0x0lor1n/spi-clip-rig/docs/schematic.png

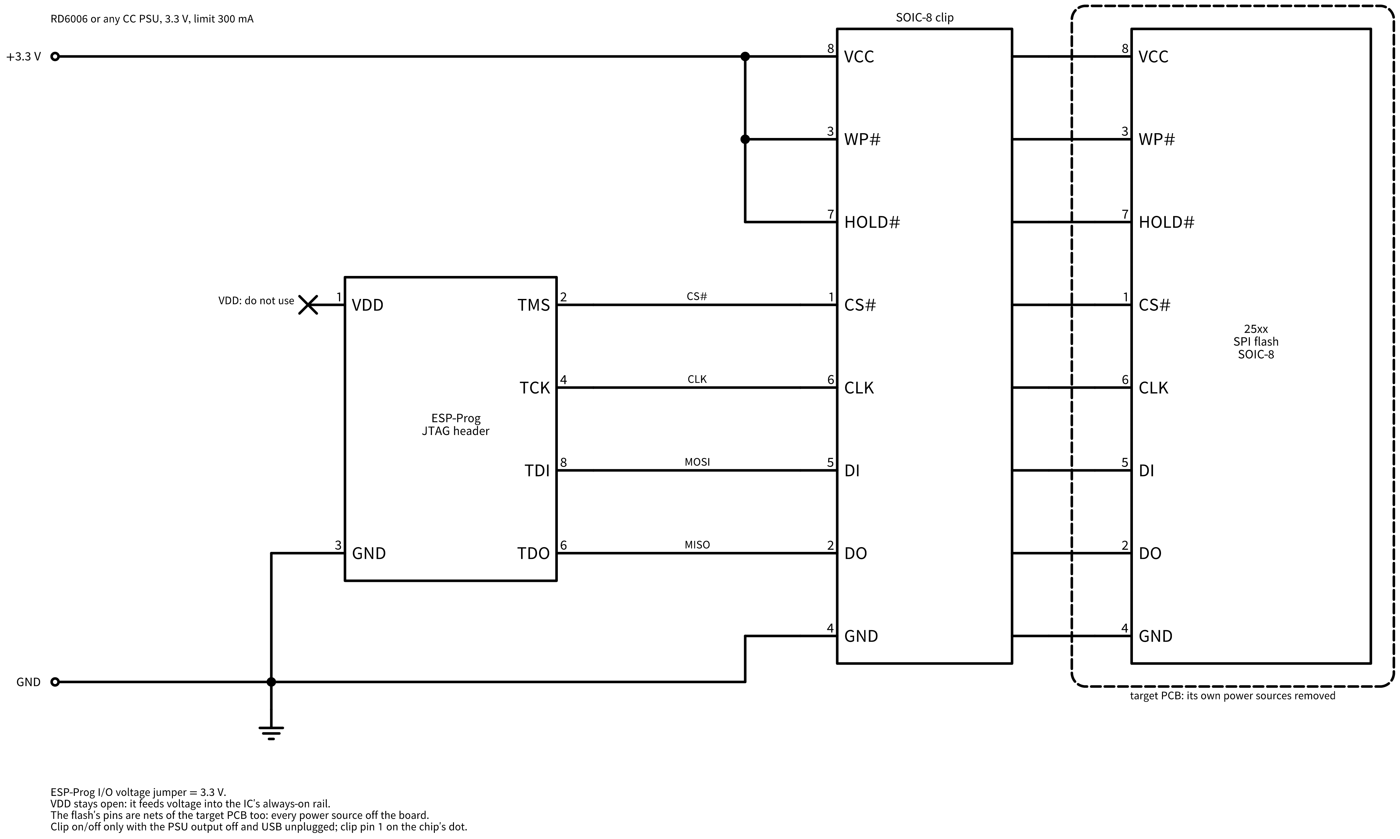
docs/schematic.png
