0x0lor1n/spi-clip-rig/(list of files, drawings)

Other design files:
docs/bench.fzz
