0x0lor1n/spi-clip-rig/docs/wiring.png

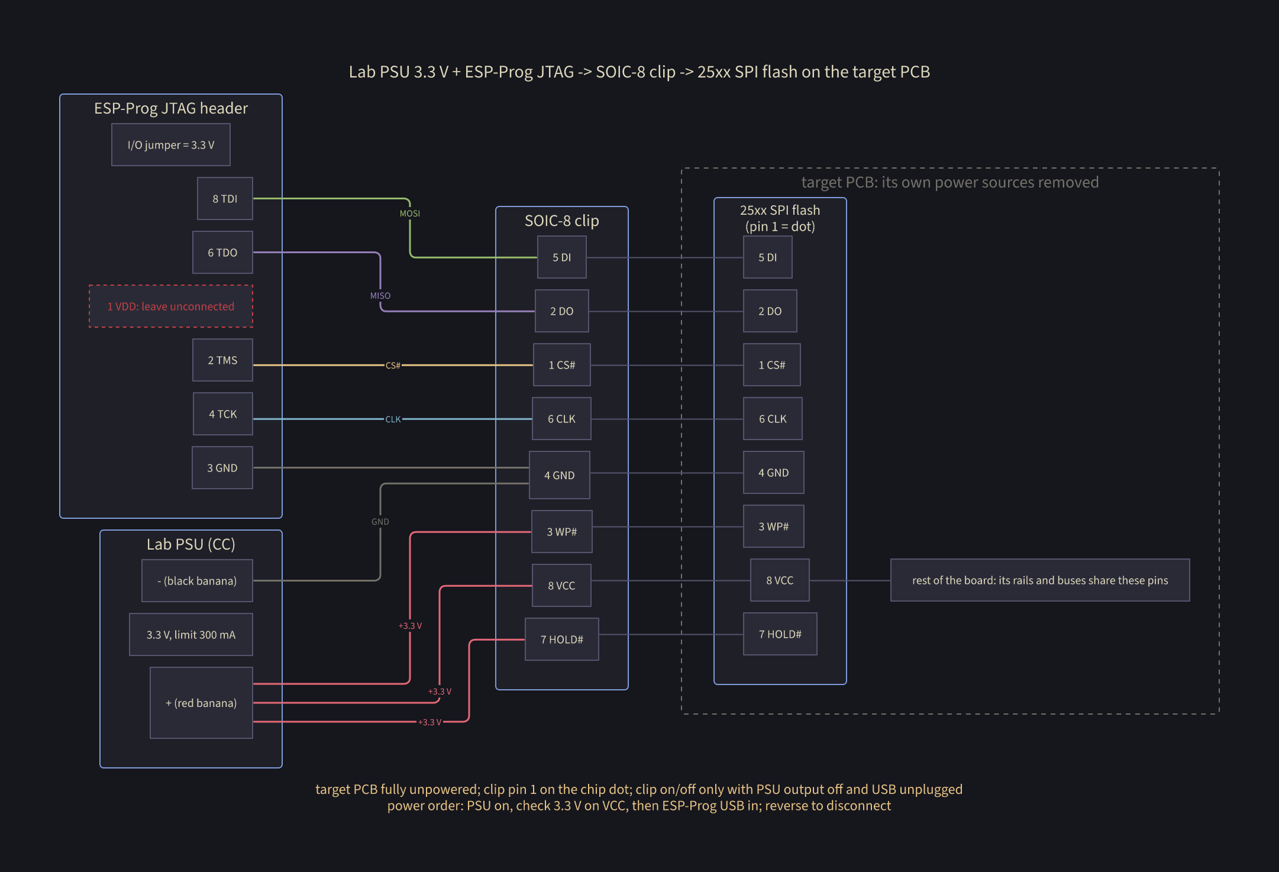
docs/wiring.png
