0x0lor1n/spi-clip-rig/(commit log)

2026-10-28 Schematic and bench wiring diagram for an ESP-Prog SPI flash reader
    ESP-Prog JTAG header to a SOIC-8 clip on a 25xx flash, VCC/WP#/HOLD# from an external current-limited 3.3 V supply, programmer VDD left open. schemdraw schematic takes pin numbers from mcubench.fritzing.{espprog,soic8clip}; docs-fresh fails when a tracked SVG no longer matches its source.
2026-10-28 Draw the flash chip behind the clip on the target PCB
    The clip is a pass-through; the schematic and wiring diagram now show contact n landing on chip pin n inside a dashed target-PCB boundary, with the board's own nets sharing those pins. Wiring diagram switches to elk: dagre crossed the GND and SPI wires.
2026-10-28 README: wiring, safety rules, connect order and the read procedure
2026-10-29 Fritzing breadboard sketch with lint and mutation cases
    docs/bench.fzz is generated by src/fritzing/gen.py: the clip on a half
    breadboard, leads to the ESP-Prog header in header order, PSU on the rails.
    gen.py checks all six nets; bench-lint re-checks them on Fritzing's own
    export and requires four mutations (CS# on VDD, CLK on TDO, PSU leads
    swapped, clip shifted) to fail. bench-fresh keeps the tracked .fzz current.
    nixpkgs moves back to mcu-bench's pin 55bfb4d: Fritzing 1.0.6 built
    against Qt 6.12 (31ecbac) aborts with a double free after `-svg`, which
    fails bench-lint. The 55bfb4d build exits cleanly.
    [bench.fzz]
